elsofgel/arshxns/Hardware/ARSHXNS_1.jpg

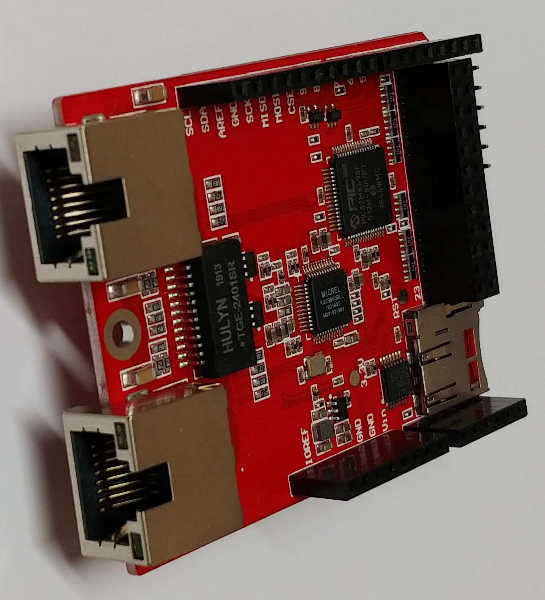
Hardware/ARSHXNS_1.jpg
