elsofgel/arshxns/Hardware/ARSHXNS_Schematic.PDF

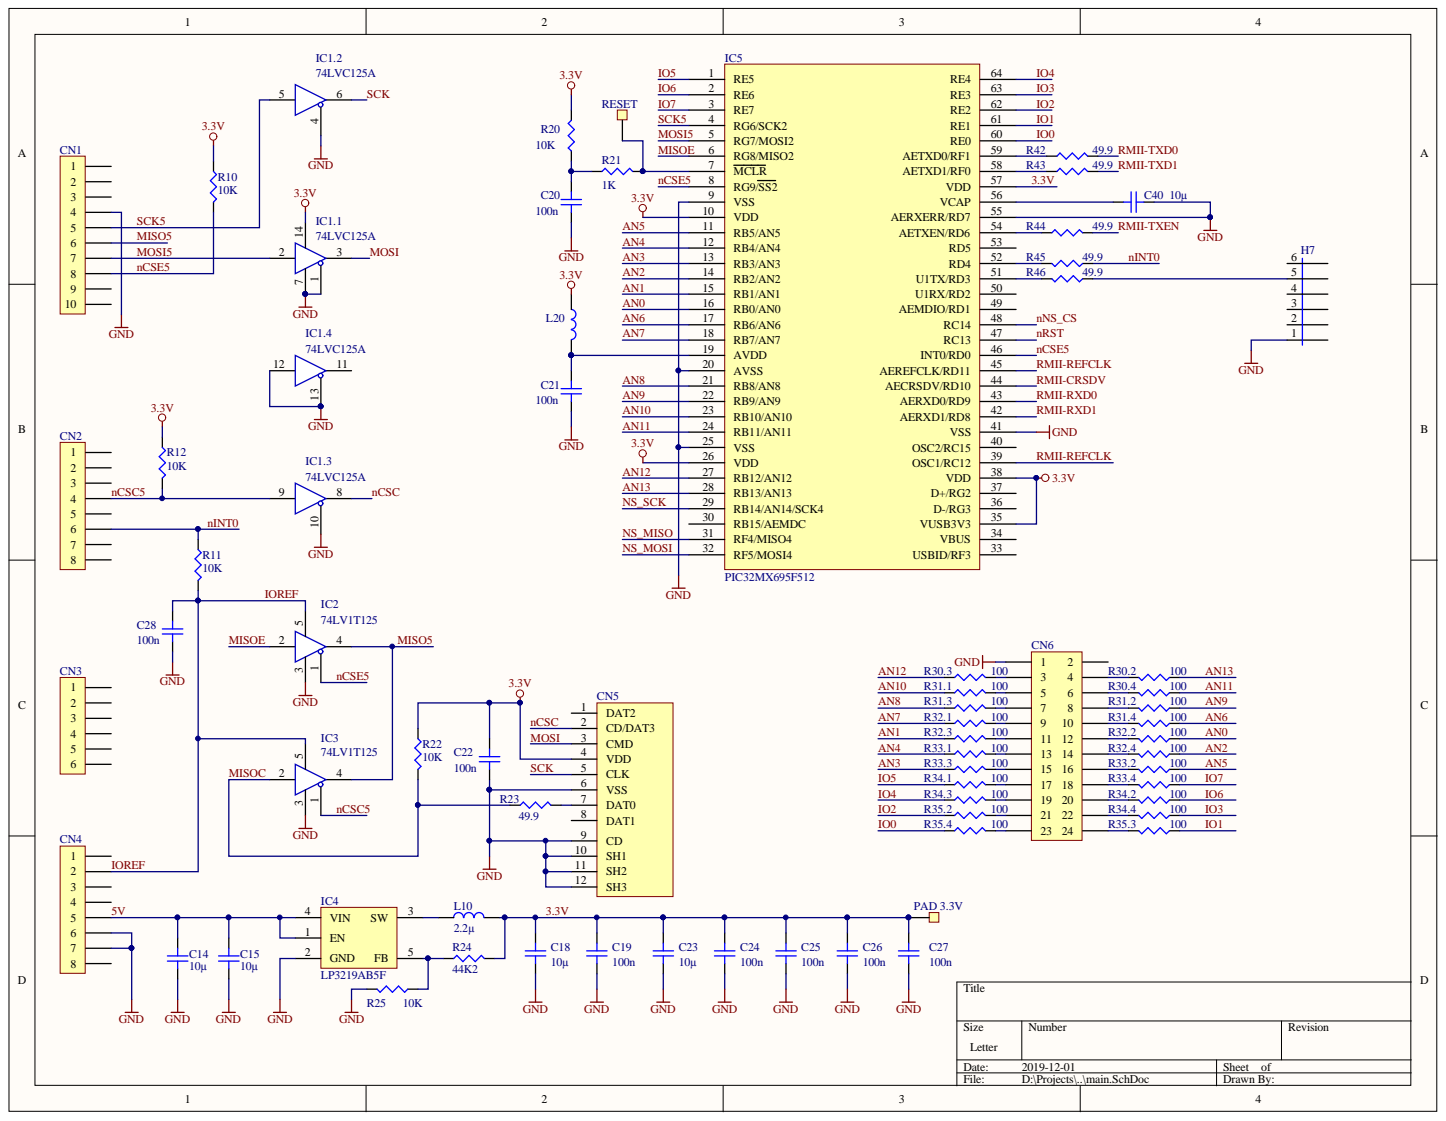
[picture p20: page 1]

SCK 5
MISO 5

1 8
1 9

2 1
2 2

2 5
2 6 2 7

1 0
1 1
1 2

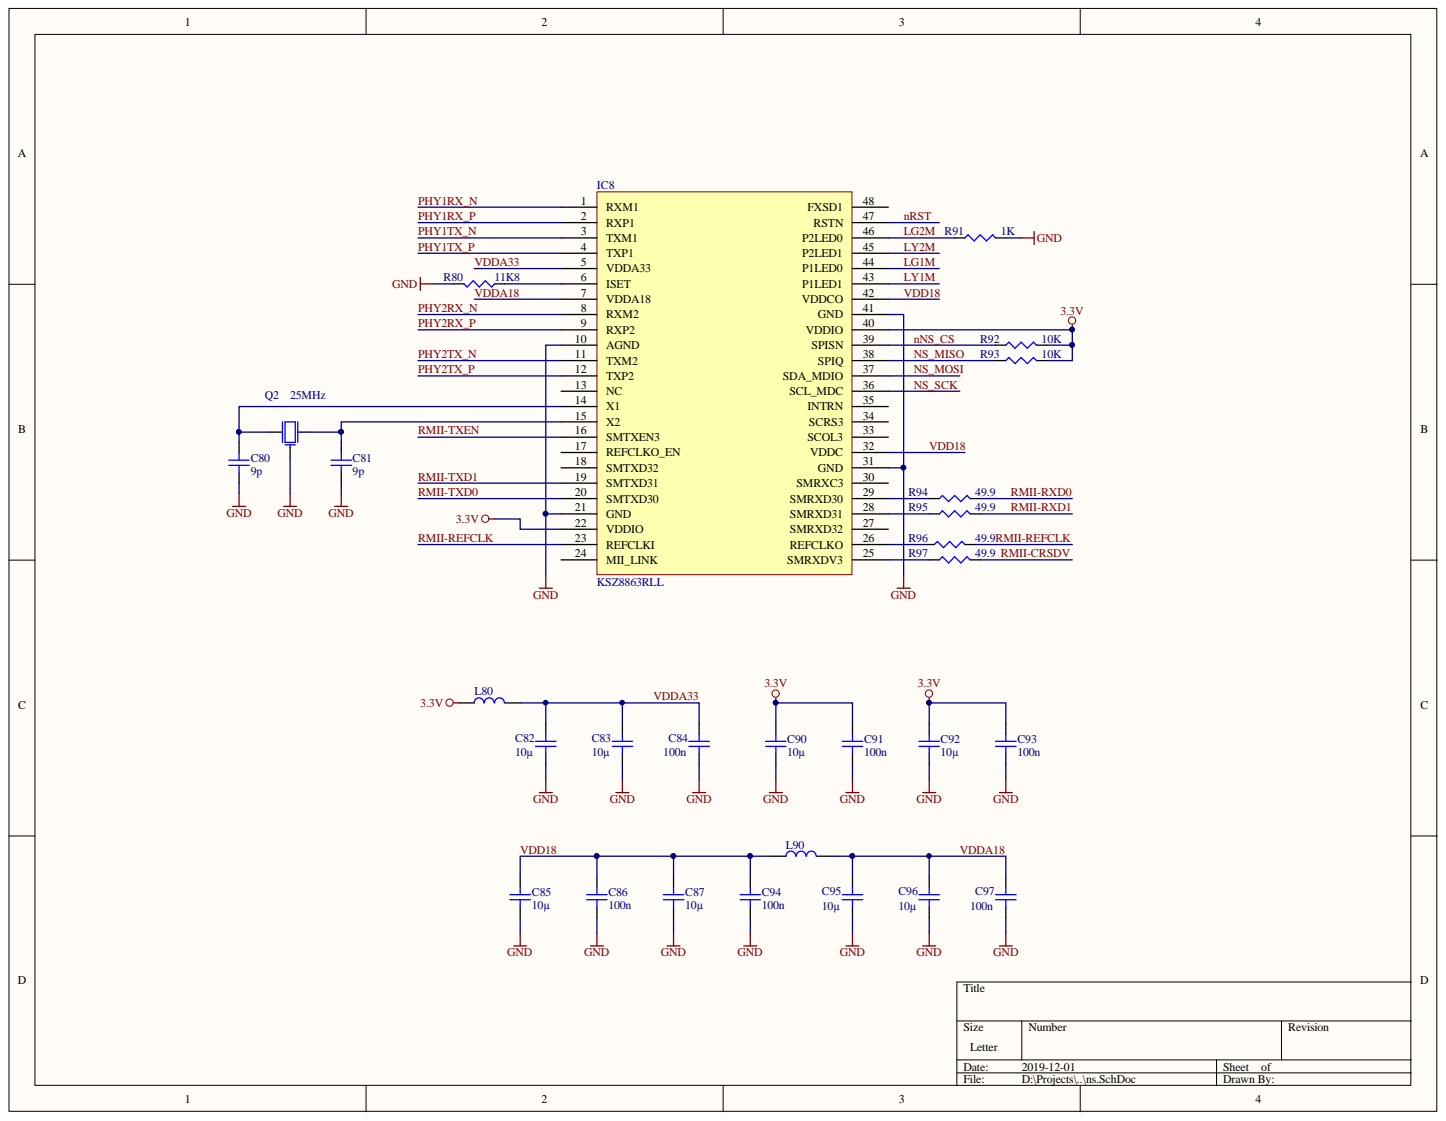
[picture p21: page 2]

AGND 10 | | nNS_CS R92 10K
TXM2 11 | | NS_MISO R93 10K
TXP2 12
NC 13

RMII-TXEN | SMTXEN3 16

REFCLKO_EN 17

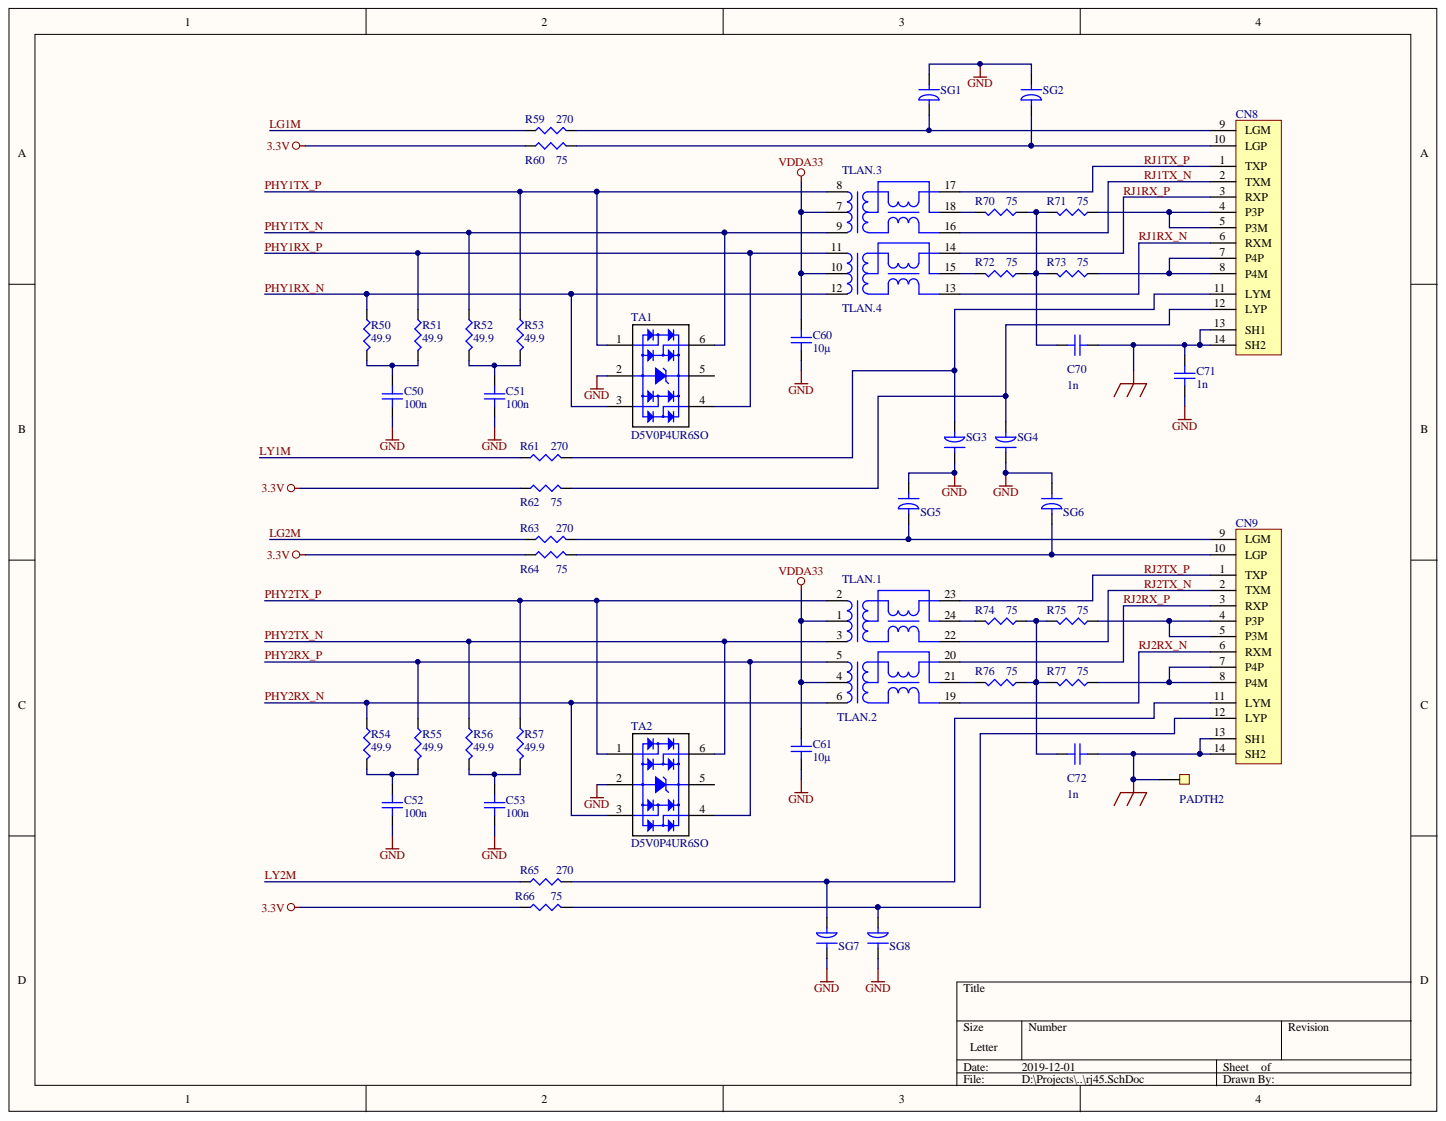
[picture p22: page 3]

RJ 1 T X_N | 2
RJ 1RX _P | 3

RJ 2 T X_N | 2
RJ 2RX _P | 3
